AjayaDahal/thrust-stand/renders/01_iso_front.png

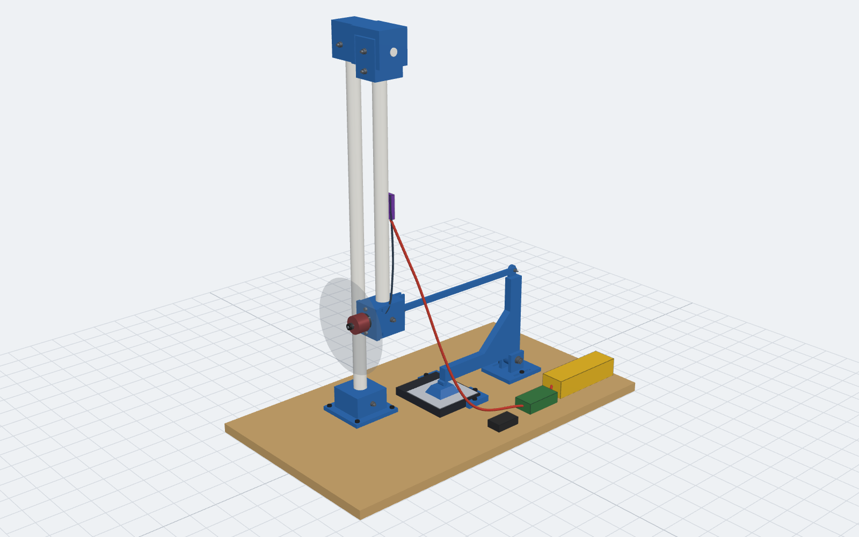
renders/01_iso_front.png
