AjayaDahal/thrust-stand/renders/02_iso_rear.png

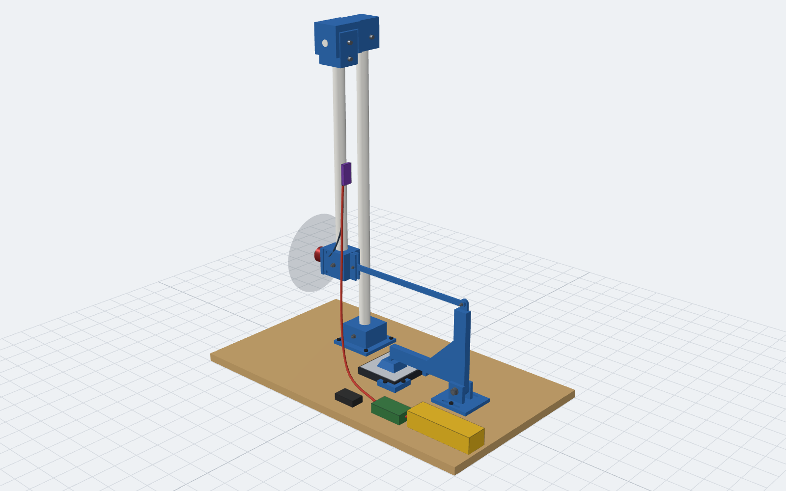
renders/02_iso_rear.png
