AjayaDahal/thrust-stand/renders/03_side.png

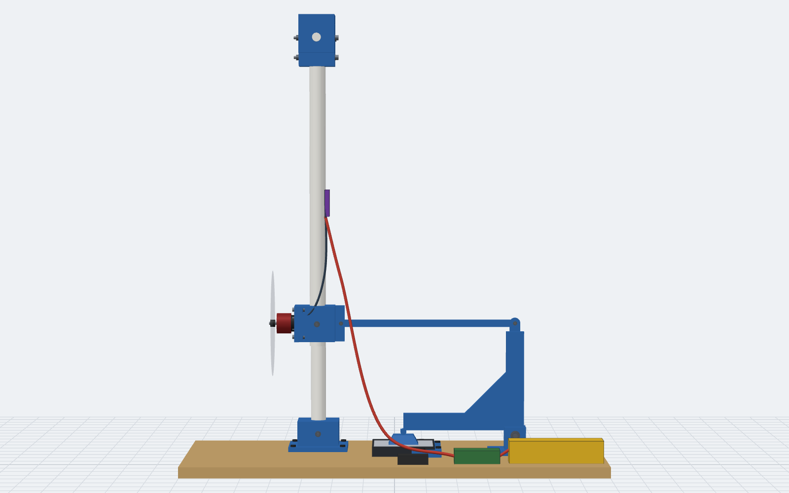
renders/03_side.png
