AjayaDahal/thrust-stand/renders/04_front_prop.png

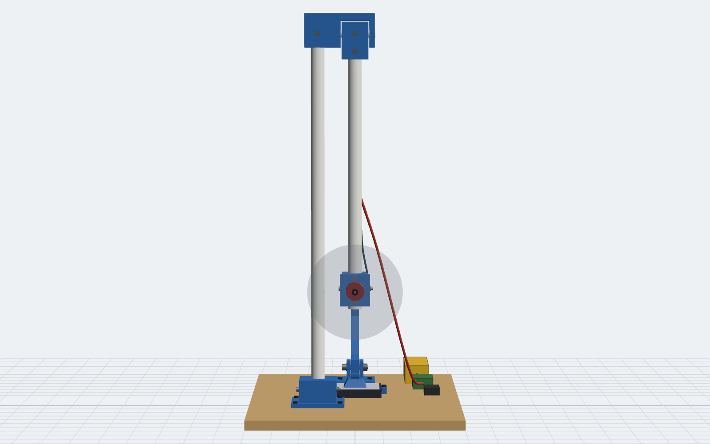
renders/04_front_prop.png
