AjayaDahal/thrust-stand/renders/05_top.png

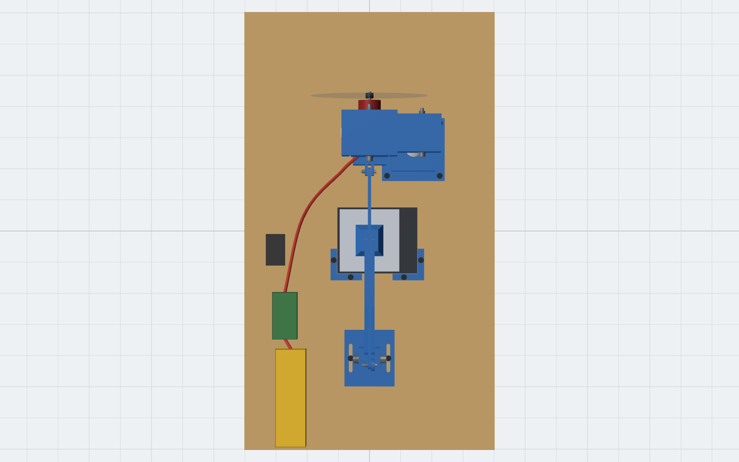
renders/05_top.png
