AjayaDahal/thrust-stand/renders/07_pivot.png

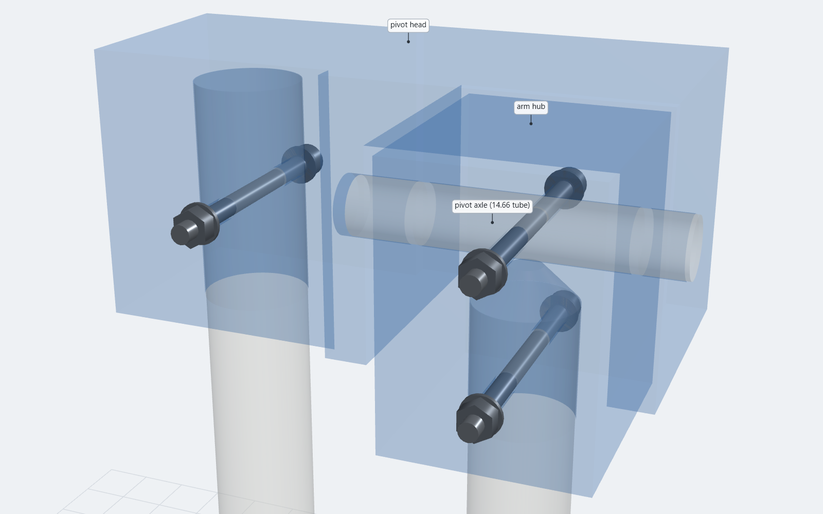
renders/07_pivot.png
