AjayaDahal/thrust-stand/renders/08_motor_fork.png

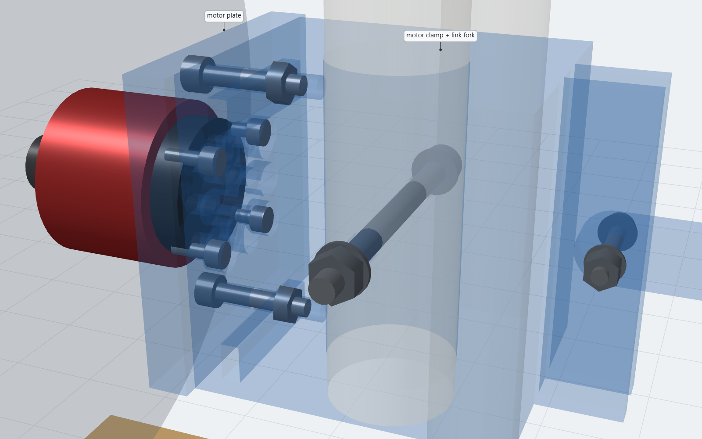
renders/08_motor_fork.png
