AjayaDahal/thrust-stand/renders/10_load_cell.png

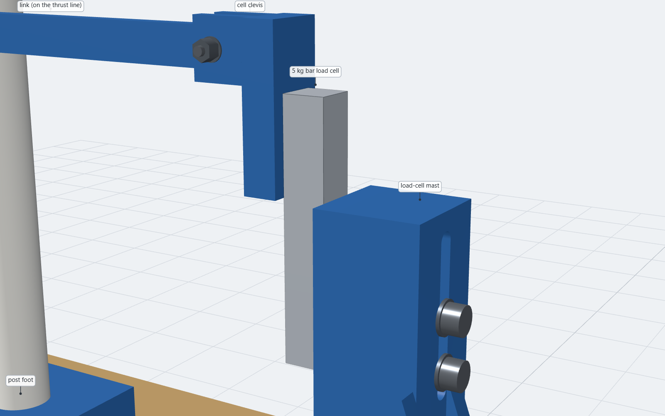
renders/10_load_cell.png
