AjayaDahal/thrust-stand/renders/11_cut_centre_plane.png

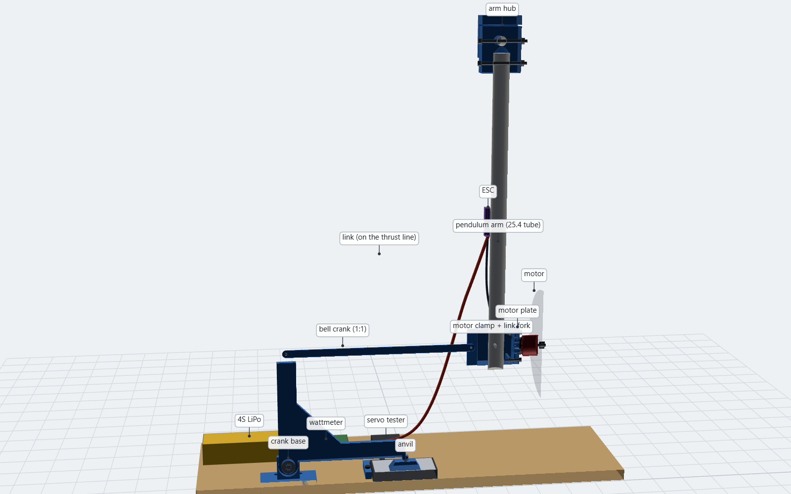
renders/11_cut_centre_plane.png
