AjayaDahal/thrust-stand/renders/12_forces_1500g.png

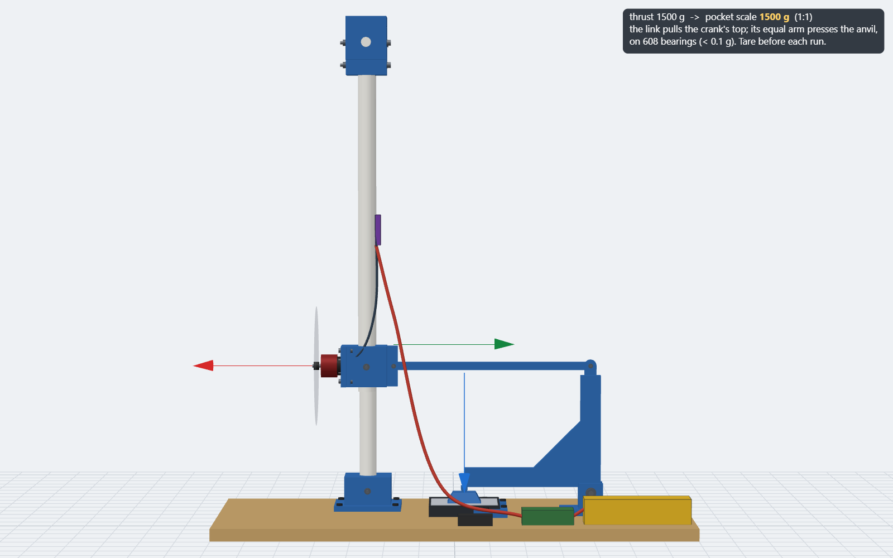
renders/12_forces_1500g.png
