AjayaDahal/thrust-stand/renders/13_burst.png

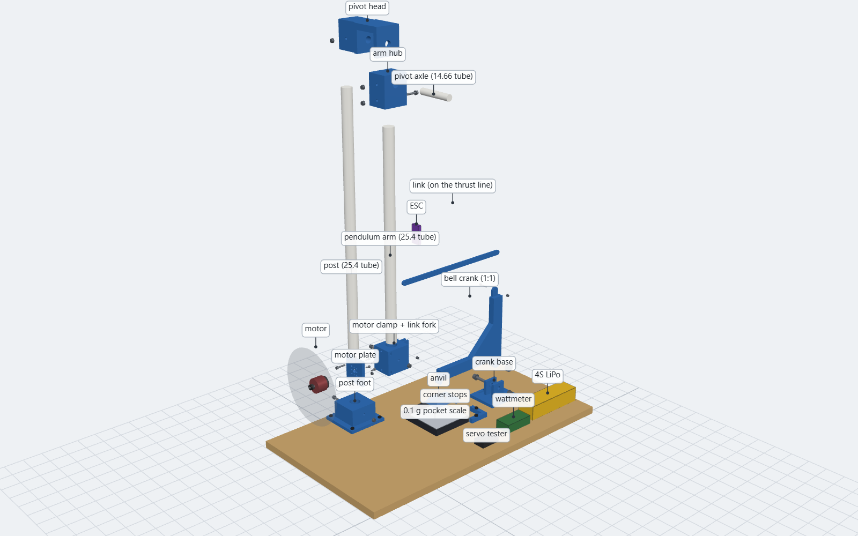
renders/13_burst.png
