AjayaDahal/thrust-stand/renders/15_swing_stop_10in.png

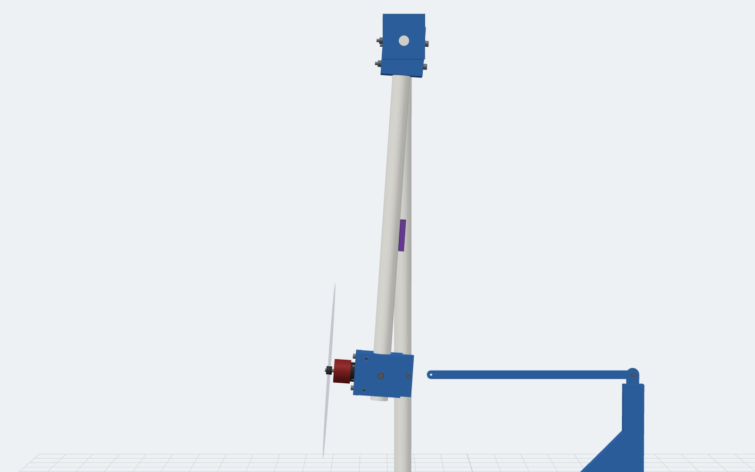
renders/15_swing_stop_10in.png
