AjayaDahal/thrust-stand/renders/17_v0_audit.png

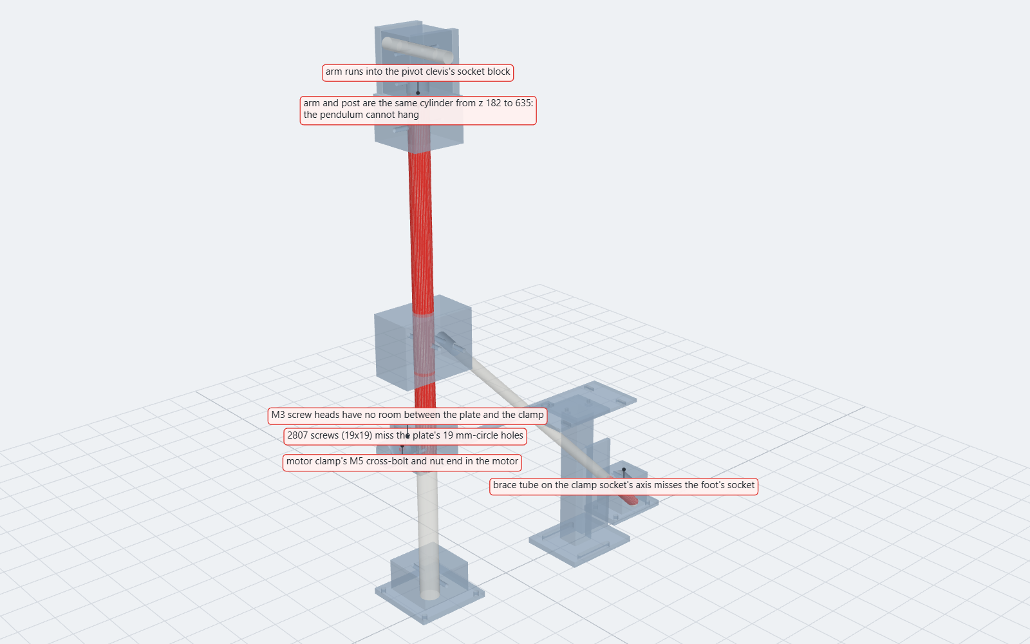
renders/17_v0_audit.png
