AjayaDahal/thrust-stand/renders/18_v0_pivot.png

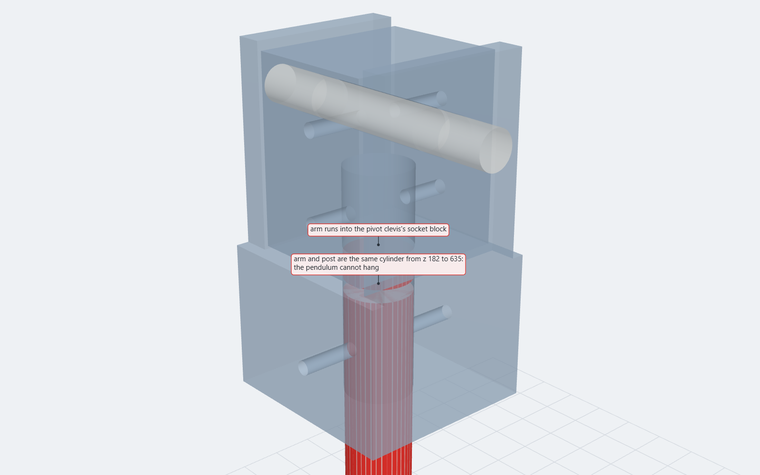
renders/18_v0_pivot.png
