AjayaDahal/thrust-stand/renders/19_v0_motor_clamp.png

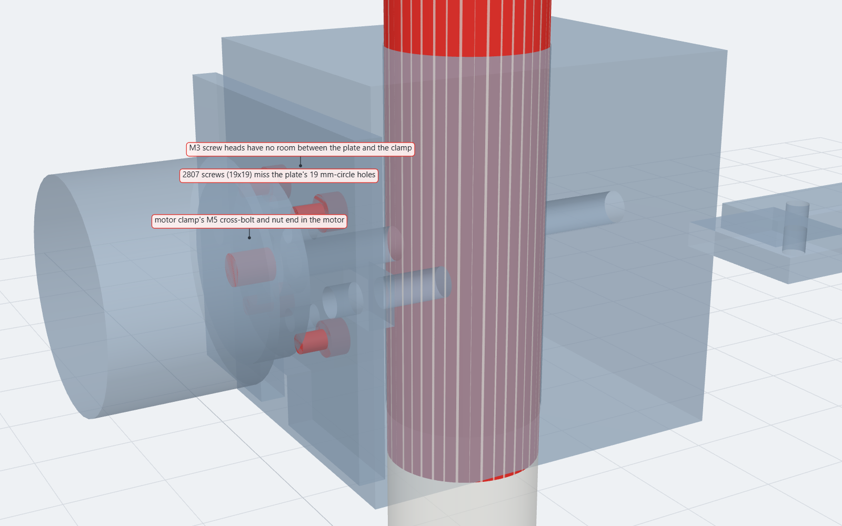
renders/19_v0_motor_clamp.png
