AjayaDahal/thrust-stand/renders/20_v0_brace_foot.png

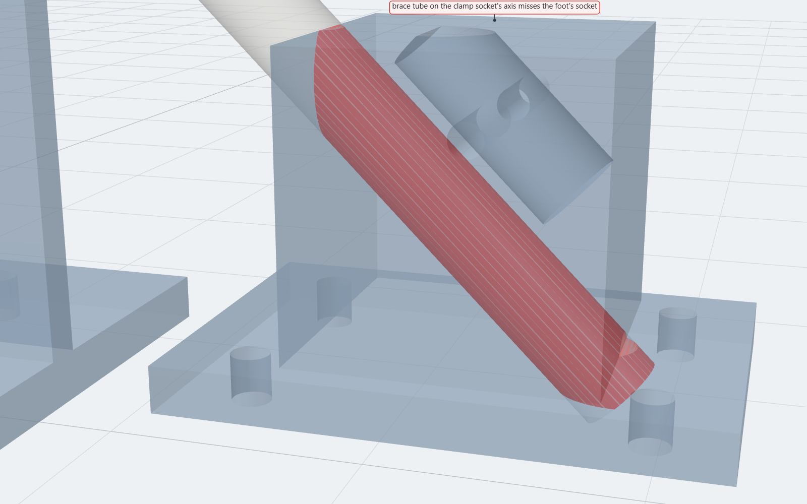
renders/20_v0_brace_foot.png
