AjayaDahal/thrust-stand/renders/21_v0_forces_1500g.png

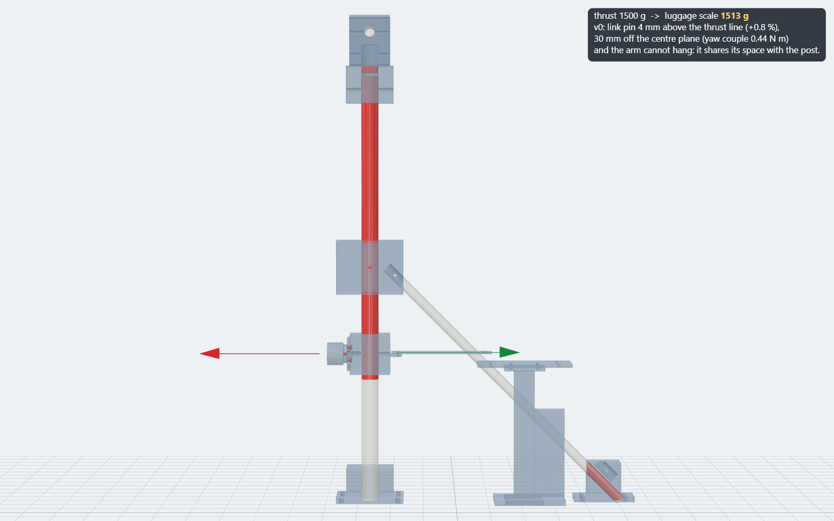
renders/21_v0_forces_1500g.png
