AjayaDahal/thrust-stand/3mf/complete_project.3mf

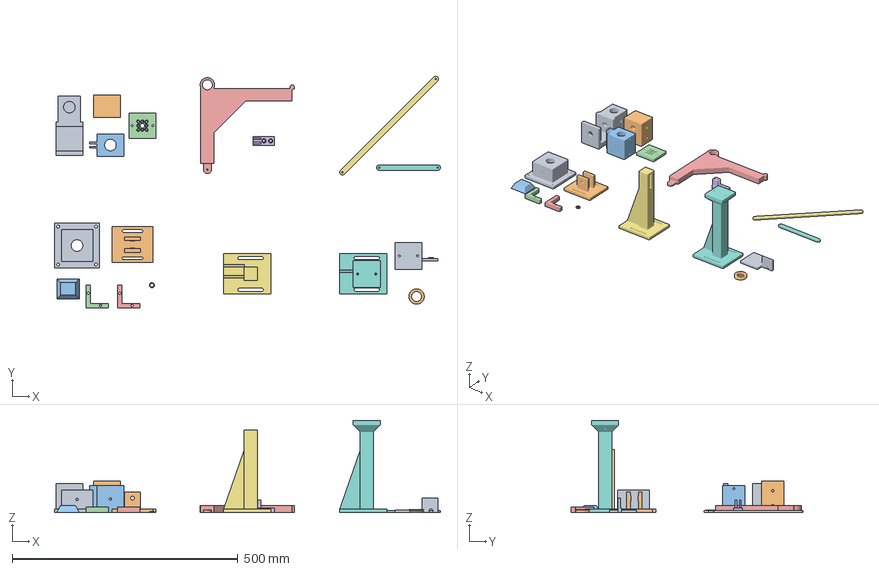
[picture p30: CAD file, 2026-11-05]
3mf/complete_project.3mf
855.8 x 513.4 x 204.0 mm
pivot_head
arm_hub
motor_clamp
motor_plate
crank
cell_clevis
crank_link
cell_link
post_foot
crank_base
scale_anvil
scale_corner x 2
crank_spacer
cell_mast
cal_mast
cal_pulley_bracket
cal_wheel
