AjayaDahal/thrust-stand/3mf/complete_project.before_fix.3mf

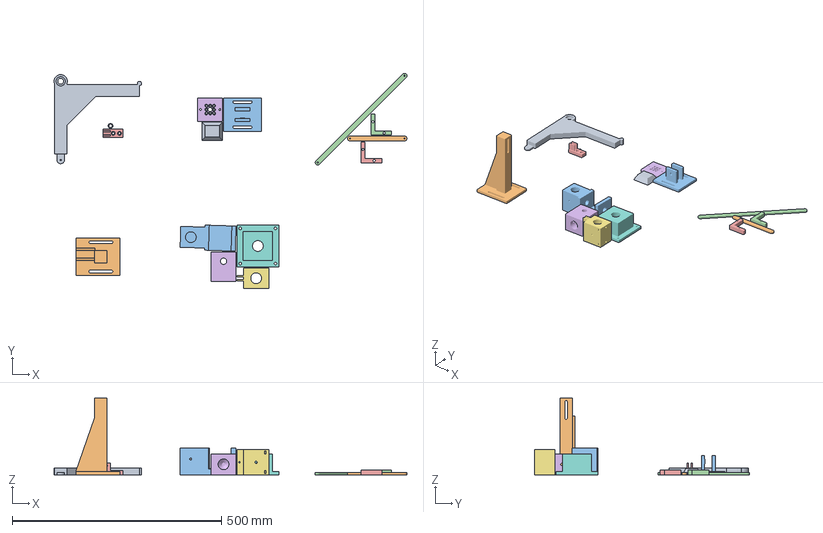
[picture p31: CAD file, 2026-11-04]
3mf/complete_project.before_fix.3mf
842.9 x 514.4 x 183.0 mm
crank.stl
cell_mast.stl
crank_base.stl
crank_link.stl
cell_clevis.stl
motor_plate.stl
crank_spacer.stl
post_foot.stl
scale_anvil.stl
cell_link.stl
pivot_head.stl
scale_corner.stl x 2
arm_hub.stl
motor_clamp.stl
