AjayaDahal/thrust-stand/3mf/arm_hub.3mf

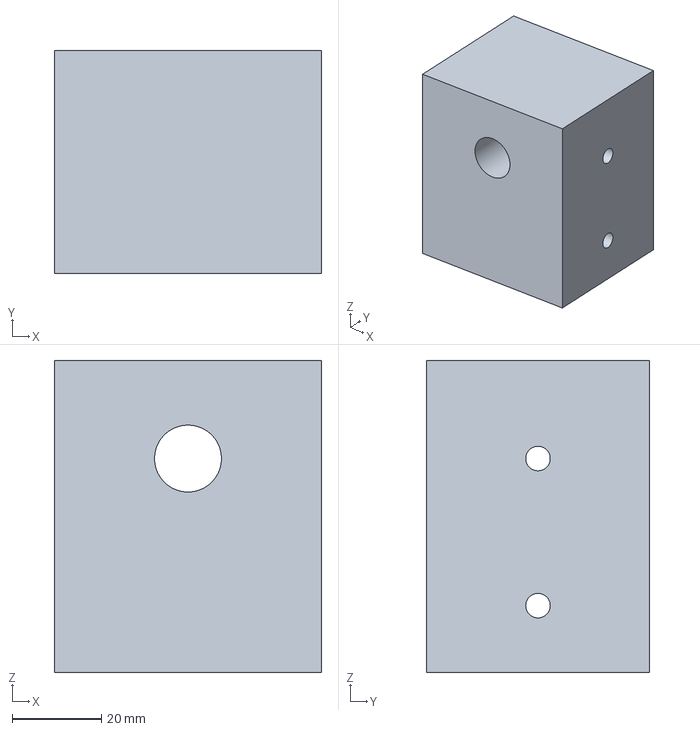
[picture p32: CAD file, 2026-11-05]
3mf/arm_hub.3mf
60.0 x 50.0 x 70.0 mm
