AjayaDahal/thrust-stand/3mf/pivot_head.3mf

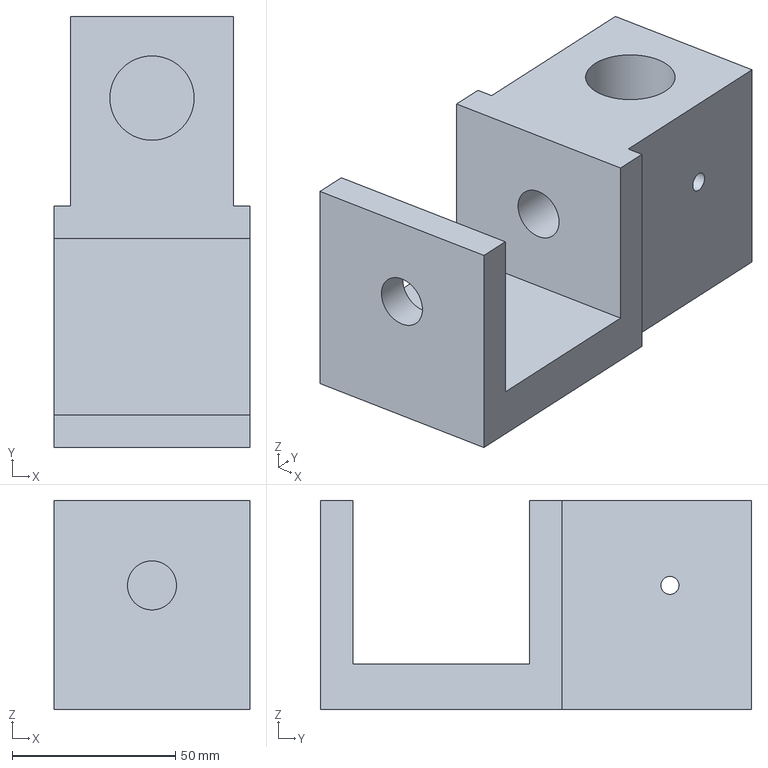
[picture p33: CAD file, 2026-11-05]
3mf/pivot_head.3mf
60.0 x 132.0 x 64.0 mm
