AjayaDahal/thrust-stand/3mf/crank_base.3mf

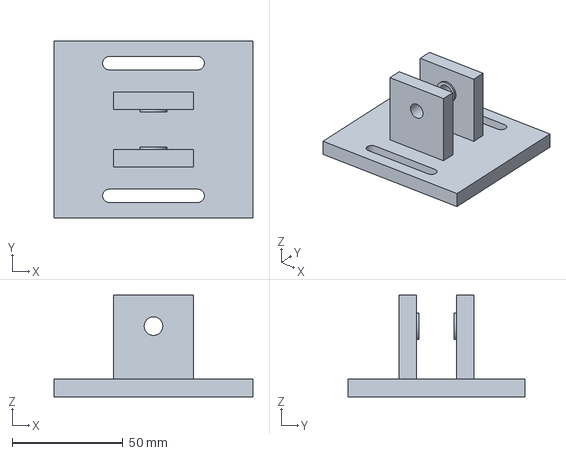
[picture p34: CAD file, 2026-11-05]
3mf/crank_base.3mf
90.0 x 80.0 x 46.0 mm
