AjayaDahal/thrust-stand/3mf/cal_pulley_bracket.3mf

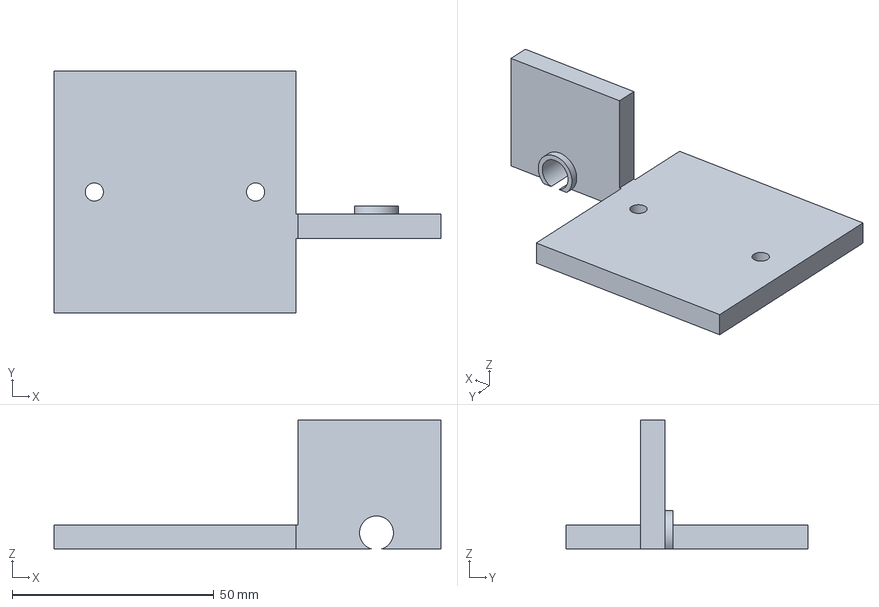
[picture p35: CAD file, 2026-11-05]
3mf/cal_pulley_bracket.3mf
96.0 x 60.0 x 32.0 mm
