AjayaDahal/thrust-stand/3mf/motor_clamp.3mf

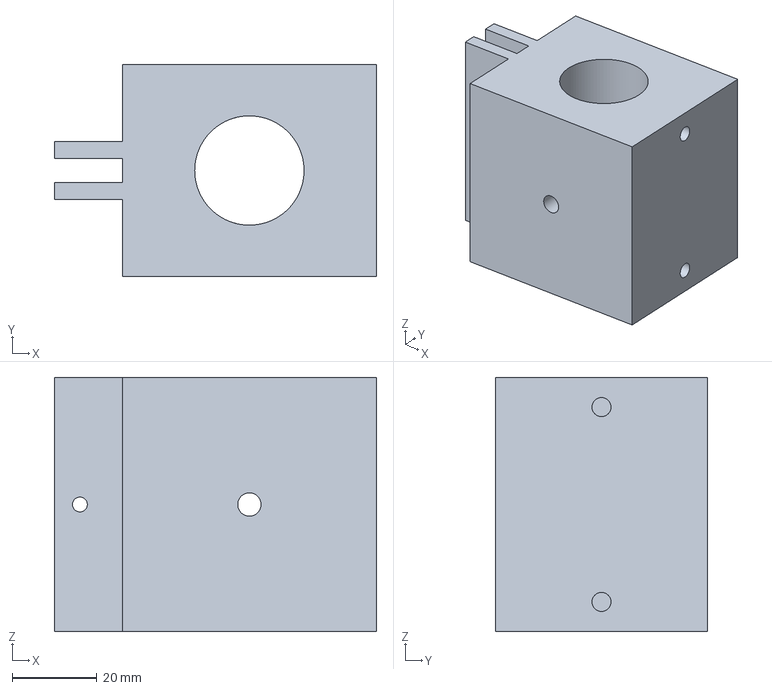
[picture p36: CAD file, 2026-11-05]
3mf/motor_clamp.3mf
76.0 x 50.0 x 60.0 mm
