AjayaDahal/thrust-stand/3mf/cell_clevis.3mf

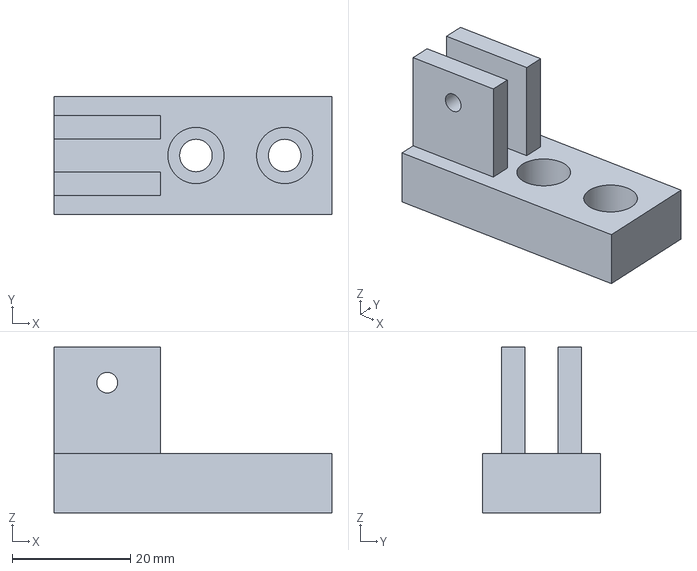
[picture p37: CAD file, 2026-11-05]
3mf/cell_clevis.3mf
47.0 x 20.0 x 28.0 mm
