AjayaDahal/thrust-stand/3mf/cell_link.3mf

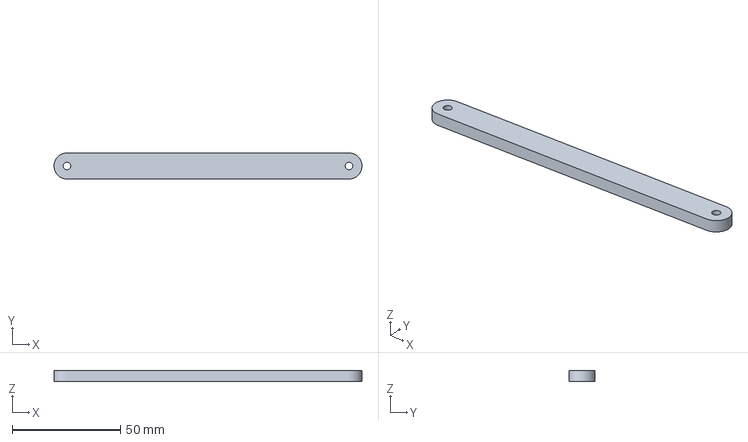
[picture p38: CAD file, 2026-11-05]
3mf/cell_link.3mf
142.0 x 12.0 x 5.00 mm
