AjayaDahal/thrust-stand/3mf/crank_link.3mf

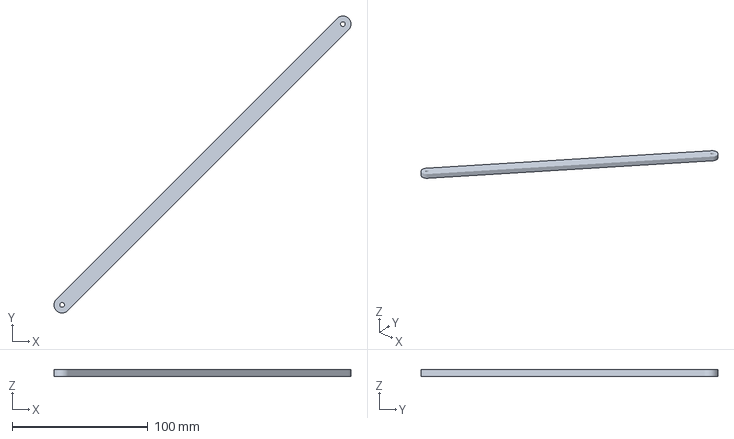
[picture p39: CAD file, 2026-11-05]
3mf/crank_link.3mf
219.2 x 219.2 x 5.00 mm
