AjayaDahal/thrust-stand/3mf/crank_spacer.3mf

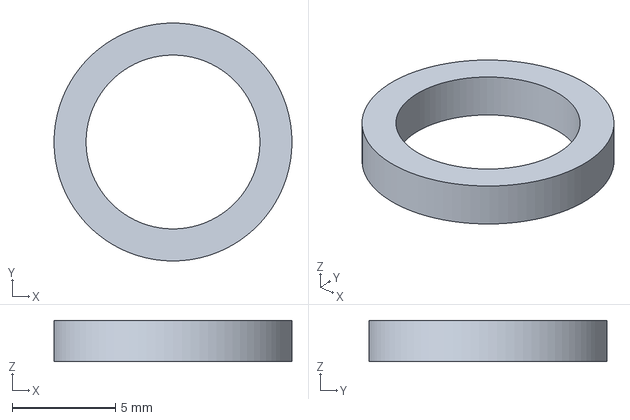
[picture p40: CAD file, 2026-11-05]
3mf/crank_spacer.3mf
11.5 x 11.5 x 2.00 mm
