AjayaDahal/thrust-stand/3mf/scale_anvil.3mf

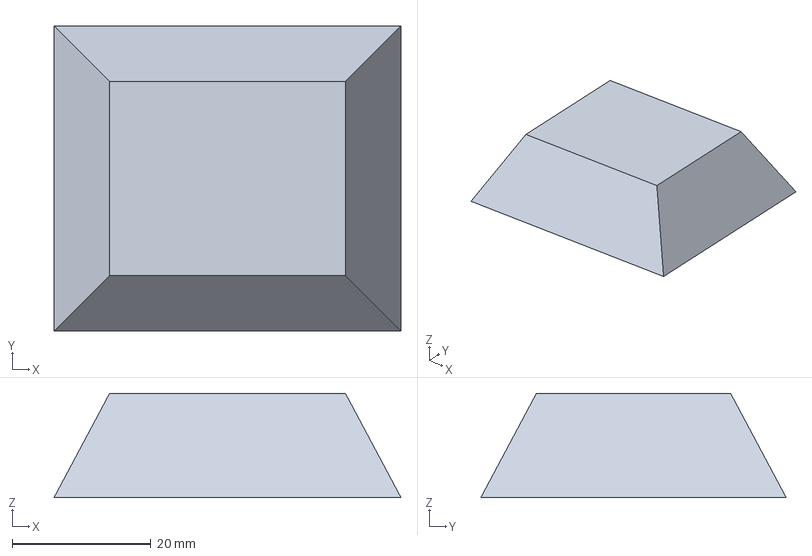
[picture p41: CAD file, 2026-11-05]
3mf/scale_anvil.3mf
50.0 x 44.0 x 15.0 mm
