AjayaDahal/thrust-stand/3mf/crank.3mf

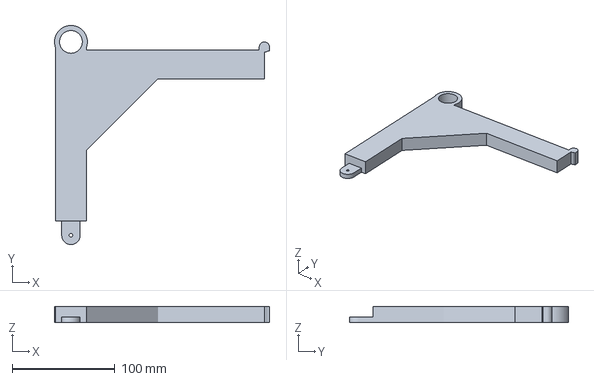
[picture p42: CAD file, 2026-11-05]
3mf/crank.3mf
209.0 x 213.0 x 16.0 mm
