AjayaDahal/thrust-stand/3mf/guy_anchor.3mf

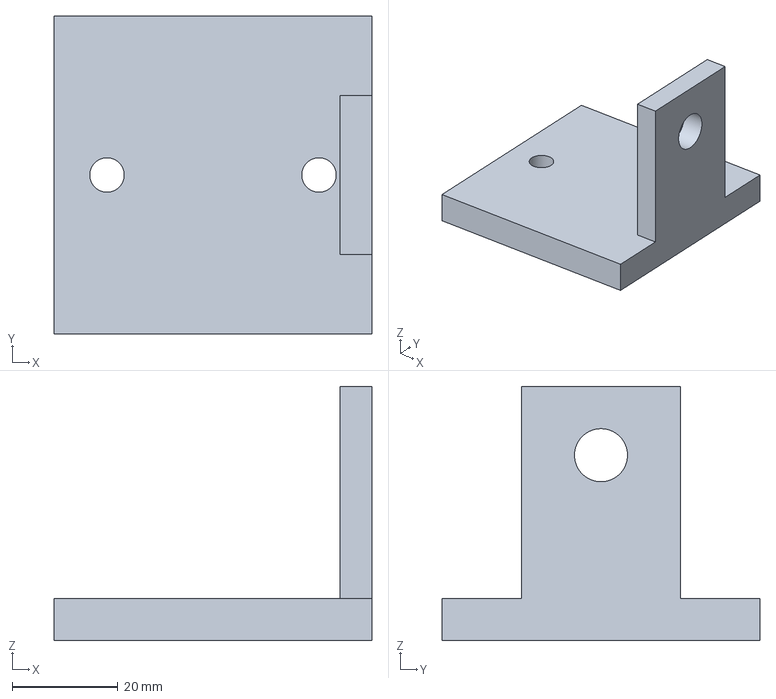
[picture p43: CAD file, 2026-11-05]
3mf/guy_anchor.3mf
60.0 x 60.0 x 48.0 mm
