AjayaDahal/thrust-stand/3mf/cell_mast.3mf

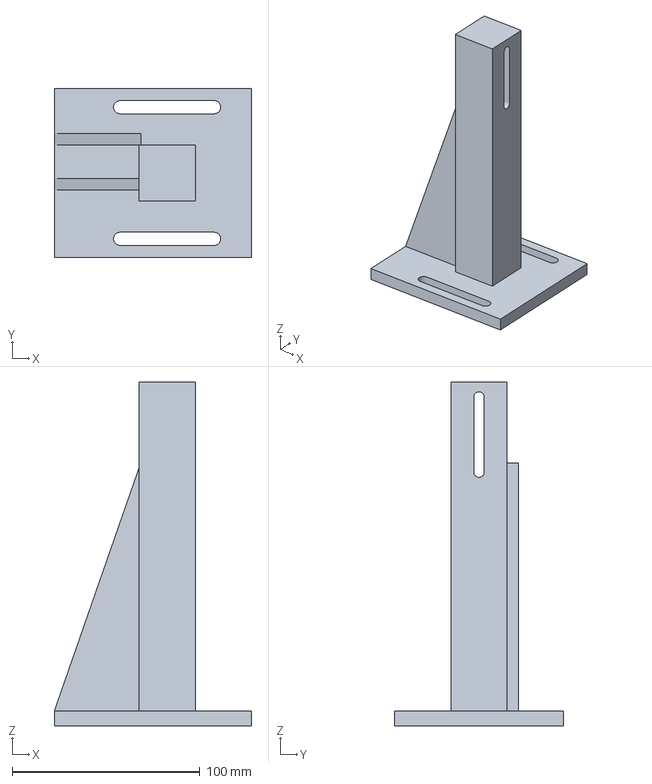
[picture p44: CAD file, 2026-11-05]
3mf/cell_mast.3mf
105.0 x 90.0 x 183.0 mm
