AjayaDahal/thrust-stand/3mf/cal_wheel.3mf

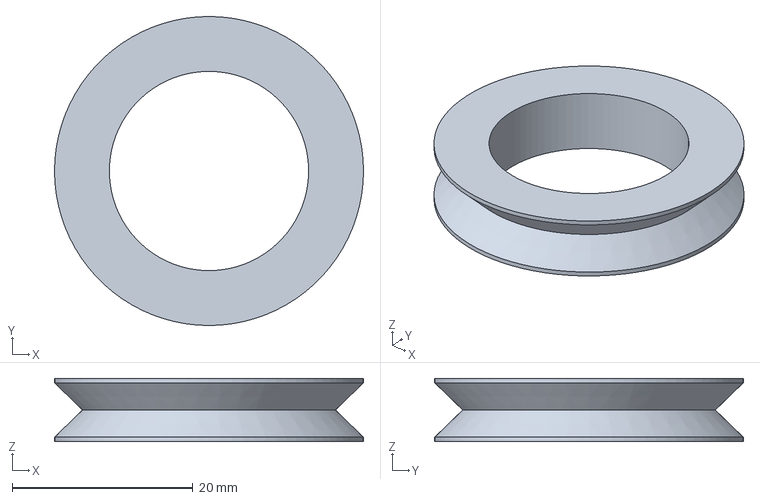
[picture p45: CAD file, 2026-11-05]
3mf/cal_wheel.3mf
34.2 x 34.2 x 7.00 mm
