AjayaDahal/thrust-stand/3mf/post_foot.3mf

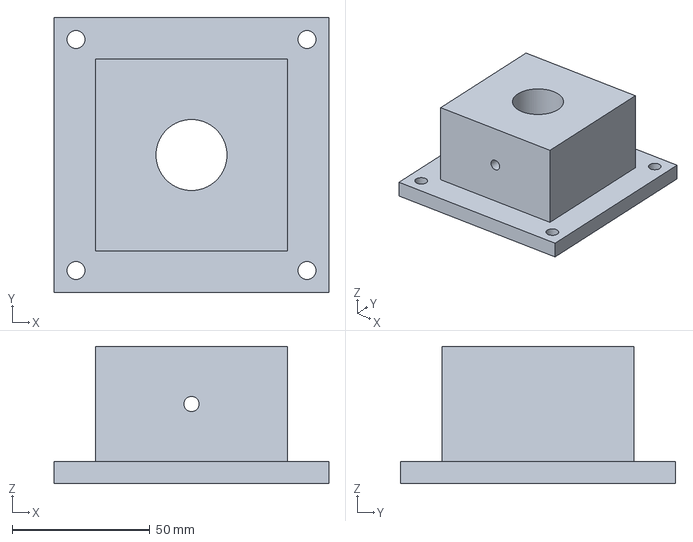
[picture p46: CAD file, 2026-11-05]
3mf/post_foot.3mf
100.0 x 100.0 x 50.0 mm
