AjayaDahal/thrust-stand/3mf/motor_plate.3mf

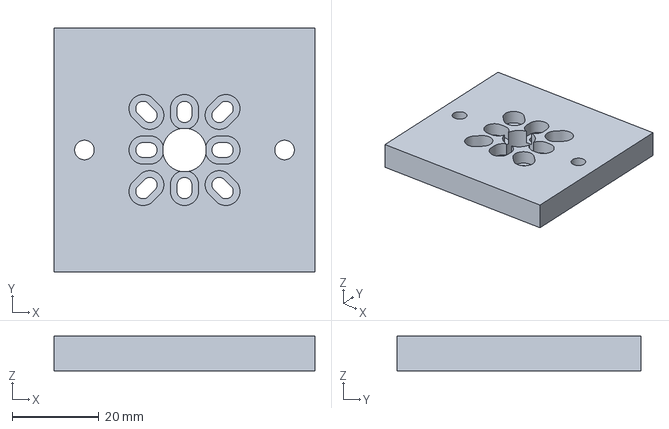
[picture p47: CAD file, 2026-11-05]
3mf/motor_plate.3mf
60.0 x 56.0 x 8.00 mm
