AjayaDahal/thrust-stand/3mf/scale_corner.3mf

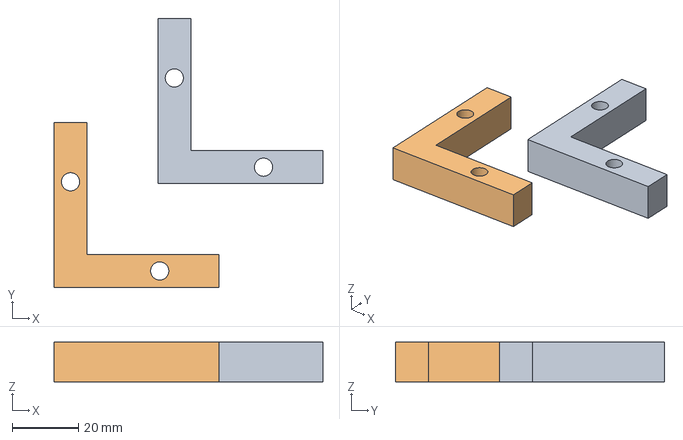
[picture p48: CAD file, 2026-11-05]
3mf/scale_corner.3mf
81.4 x 81.4 x 12.0 mm
scale_corner.stl x 2
