AjayaDahal/thrust-stand/3mf/cal_mast.3mf

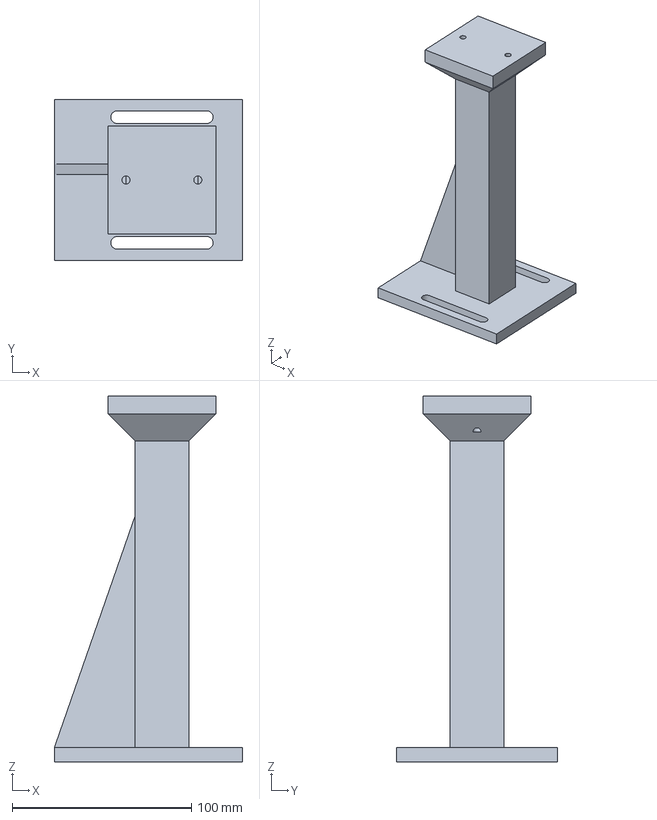
[picture p49: CAD file, 2026-11-05]
3mf/cal_mast.3mf
105.0 x 90.0 x 204.0 mm
