AjayaDahal/thrust-stand/(list of files, cad)

Other CAD files:
stl/arm_hub.stl
stl/cal_mast.stl
stl/cal_pulley_bracket.stl
stl/cal_wheel.stl
stl/cell_clevis.stl
stl/cell_link.stl
stl/cell_mast.stl
stl/crank.stl
stl/crank_base.stl
stl/crank_link.stl
stl/crank_spacer.stl
stl/guy_anchor.stl
stl/motor_clamp.stl
stl/motor_plate.stl
stl/pivot_head.stl
stl/post_foot.stl
stl/scale_anvil.stl
stl/scale_corner.stl
v0_archive/audit/clash_arm_clevis.stl
v0_archive/audit/clash_arm_post.stl
v0_archive/audit/clash_bolt_motor.stl
v0_archive/audit/clash_brace_foot.stl
v0_archive/audit/clash_heads_clamp.stl
v0_archive/audit/clash_screws_plate.stl
v0_archive/stl/arm_hub.stl
v0_archive/stl/brace_clamp.stl
v0_archive/stl/brace_foot.stl
v0_archive/stl/guy_anchor.stl
v0_archive/stl/motor_clamp.stl
v0_archive/stl/motor_plate_2212.stl
v0_archive/stl/motor_plate_2807.stl
v0_archive/stl/pivot_clevis.stl
v0_archive/stl/post_foot.stl
v0_archive/stl/scale_link.stl
v0_archive/stl/scale_mast.stl
v0_archive/stl/scale_platform.stl
v0_archive/stl/shim_plate.stl
