AjayaDahal/thrust-stand/renders/14_calibration.png

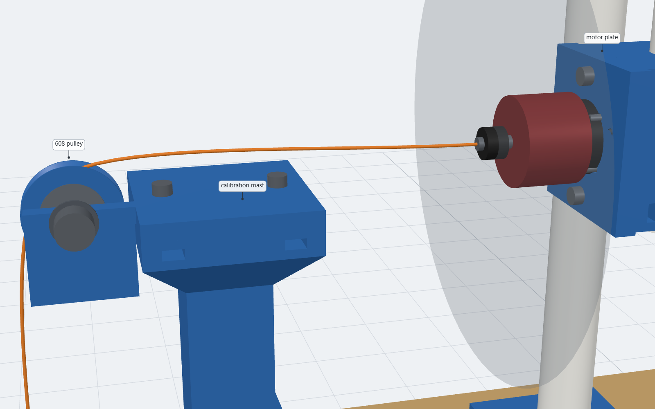
renders/14_calibration.png
