AjayaDahal/thrust-stand/scripts/geom.py

"""Small numpy helpers shared by the scripts: binary STL read/write and 4x4 transforms."""
import os
import struct

import numpy as np

ROOT = os.path.normpath(os.path.join(os.path.dirname(os.path.abspath(__file__)), ".."))
STL = os.path.join(ROOT, "stl")


def read_stl(path):
    """Triangles of a binary or ASCII STL as an (n, 3, 3) float64 array."""
    with open(path, "rb") as f:
        data = f.read()
    if data[:5] == b"solid" and b"facet" in data[:400]:
        v = [list(map(float, line.split()[1:4])) for line in data.decode(errors="replace").splitlines()
             if line.strip().startswith("vertex")]
        return np.array(v, float).reshape(-1, 3, 3)
    n = struct.unpack("<I", data[80:84])[0]
    rec = np.frombuffer(data, dtype=np.dtype([("n", "<f4", 3), ("v", "<f4", (3, 3)), ("a", "<u2")]), count=n, offset=84)
    return rec["v"].astype(np.float64)


def write_stl(path, tris):
    tris = np.asarray(tris, np.float32).reshape(-1, 3, 3)
    n = np.cross(tris[:, 1] - tris[:, 0], tris[:, 2] - tris[:, 0])
    n /= np.maximum(np.linalg.norm(n, axis=1, keepdims=True), 1e-12)
    rec = np.zeros(len(tris), dtype=np.dtype([("n", "<f4", 3), ("v", "<f4", (3, 3)), ("a", "<u2")]))
    rec["n"], rec["v"] = n, tris
    os.makedirs(os.path.dirname(path), exist_ok=True)
    with open(path, "wb") as f:
        f.write(b"thrust stand".ljust(80, b" "))
        f.write(struct.pack("<I", len(tris)))
        f.write(rec.tobytes())


def rot(axis, deg):
    """3x3 rotation about a principal axis ('x', 'y' or 'z'), right-handed."""
    c, s = np.cos(np.radians(deg)), np.sin(np.radians(deg))
    return {"x": np.array([[1, 0, 0], [0, c, -s], [0, s, c]]),
            "y": np.array([[c, 0, s], [0, 1, 0], [-s, 0, c]]),
            "z": np.array([[c, -s, 0], [s, c, 0], [0, 0, 1]])}[axis].round(12)


def apply(tris, R=None, t=(0.0, 0.0, 0.0)):
    out = np.asarray(tris, float).reshape(-1, 3)
    if R is not None:
        out = out @ np.asarray(R, float).T
    return (out + np.asarray(t, float)).reshape(-1, 3, 3)


def mat4(R=None, t=(0.0, 0.0, 0.0)):
    M = np.eye(4)
    if R is not None:
        M[:3, :3] = R
    M[:3, 3] = t
    return M
