AjayaDahal/thrust-stand/(commit log)

2026-11-03 Thrust stand v1: pendulum stand with a bell crank on a 0.1 g pocket scale
    - Pendulum: the motor hangs 480 mm below a pivot head beside the post; the
    link pin sits on the thrust line, so the link pulls with the thrust 1:1.
    - Bell crank on two 608 bearings (arms 188 mm) turns the pull into a press on
    a printed anvil standing on a YONCON 3000 g x 0.1 g pocket scale; the same
    scale weighs the VTOL's parts. Load-cell option and calibration pulley kept.
    - Parametric build123d source, gate (9/9: collisions, bolts, nut walls, motor
    patterns, 1:1 geometry, swing stop, prop clearance, printability), Kobra S1
    G-code, three.js viewer, renders, BOM and design review.
    - v0_archive/: the first dr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
    [arm_hub.stl, brace_clamp.stl, brace_foot.stl, cal_mast.stl, cal_pulley_bracket.stl, cal_wheel.stl, cell_clevis.stl, cell_link.stl]
2026-11-03 Add Kobra S1 G-code (1/4): cal_mast, motor_clamp
2026-11-03 Add Kobra S1 G-code (4/4): cell_mast, crank_base, motor_plate, guy_anchor, cal_pulley_bracket, cell_clevis, crank_link, scale_corner, scale_anvil, cell_link, cal_wheel, crank_spacer
2026-11-04 Add Anycubic Slicer Next projects (3mf/) for every print file
    Each 3MF holds the part in print orientation with the Kobra S1 printer, PETG thrust stand process and PETG filament settings; scripts/export_3mf.py builds them and re-slices each to check it against gcode/. The PETG filament profile now lists the Kobra S1 as compatible.
    [arm_hub.3mf, cal_mast.3mf, cal_pulley_bracket.3mf, cal_wheel.3mf, cell_clevis.3mf, cell_link.3mf, cell_mast.3mf, crank.3mf]
2026-11-04 Add combined 6-plate slicer project: PETG plates 1-3 at 30% infill, PLA plates 4-6 at 15%
    arm_hub restored upright, wider part gaps, calibration rig added on plate 6. complete_project.before_fix.3mf is the original it was fixed from.
    [complete_project.3mf, complete_project.before_fix.3mf]
2026-11-05 v1.1: straight bearing bore in the crank; the gate now rejects holes through ceilings
    First print: strands filled the crank's bed-side bearing seat. v1's 2 mm shoulder between the two 608 seats had a 14 mm hole; printed flat, the shoulder started over the empty seat and the slicer laid the hole's walls on air. The gate had passed it as an 8 mm bridge (ring width).
    crank: one straight 22.1 mm bore; the bearings press in flush, 2 mm apart (the spacer). check_stand gate 9: a ceiling loop whose walls all rise from it is a hole through it, > 6 mm fails (v1 crank: 14 mm). PETG process: counterbore_hole_bridging = partiallybridge (cal_mast's nut-slot holes). PETG filament: 80 C on the textured PEI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
    [arm_hub.3mf, cal_mast.3mf, cal_pulley_bracket.3mf, cal_wheel.3mf, cell_clevis.3mf, cell_link.3mf, cell_mast.3mf, complete_project.3mf]
2026-11-05 Re-slice Kobra S1 G-code with Anycubic Slicer Next 2.0.0.3 (1/4): cal_mast, motor_clamp
2026-11-05 Re-slice Kobra S1 G-code with Anycubic Slicer Next 2.0.0.3 (4/4): cell_mast, crank_base, motor_plate, guy_anchor, cal_pulley_bracket, scale_anvil, cell_clevis, crank_link, scale_corner, cell_link, ca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
2026-11-05 Re-render the print-files gallery (Slicer Next 2.0.0.3 masses and times) and the centre-plane cut (v1.1 crank bore)
2026-11-07 Add a cut-and-drill guide for the tubes and a board layout drawing
    make_diagram.py now also writes cut_guide.png (post, arm and axle laid out like rulers from the end you measure from, with each printed part and cross-bolt) and board_layout.png (every part's place on the board, measured from the arm axis). Both come from build_thrust_stand.py's numbers. README shows them in the tube cut list and the assembly.
